jovanajanjatovic/Poboljsani-Haulandov-strujni-generator/README.md

U okviru predmeta Teorija električnih kola rađen je projekat o poboljšanom Houlandovom strujnom generatoru.
Ovo kolo predstavlja aktivni generator struje kod koga se odgovarajućim izborom otpornika postiže približno konstantna izlazna struja u zavisnosti od ulaznog napona

2025/2026<br>
Studentkinje: Mira Vukmirović i Jovana Janjatović<br>
Nastavnik: dr Nikola Basta, docent<br>
