jovanajanjatovic/Poboljsani-Haulandov-strujni-generator/zavisnost struje od otpora potrosaca.pdf

Rload [Ω] | Napon na Rload [V] | Struja kroz Rload [mA]
300 | 0.507 | 1.69
200 | 0.336 | 1.68
510 | 0.862 | 1.69
1500 | 2.462 | 1.64
5400 | 8.568 | 1.59
8000 | 12.16 | 1.52
