jovanajanjatovic/Poboljsani-Haulandov-strujni-generator/TEK_Projekat_Tim01_PoboljsaniHaulandovStrujniGenerator.pdf

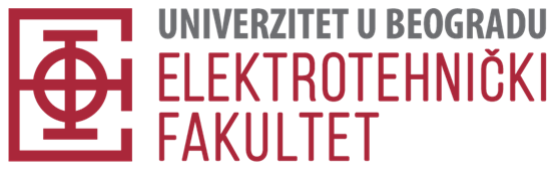
[picture p1: figure]

# Poboljšani Haulandov strujni generator

### Teorija električnih kola

2025/2026

## Tim 01

Studenti: Jovana Janjatović, Mira Vukmirović Nastavnik: dr Nikola Basta, docent

## Sadržaj

## 1. O poboljšanom Haulandovom strujnom generatoru

U okviru predmeta Teorija električnih kola izvodimo projekat o poboljšanom Haulandovom¹ strujnom generatoru. Ovo kolo predstavlja aktivni generator struje kod koga se odgovarajućim izborom otpornika postiže približno konstantna izlazna struja u zavisnosti od ulaznog napona.

Analizirano kolo se sastoji od operacionog pojačavača, mreže otpornika za ostvarivanje povratne sprege i opterećenja na izlazu. Kao referentna topologija korišćeno je kolo predstavljeno na Slici 1 preuzete iz [1], uz zamenu operacionog pojačavača OPA192 pojačavačem TL082.

Za simbolički proračun je rađen ručno, a za dodatni proveru i grafičke prikaze korišćen je programski jezik Python uz biblioteku SymPy, dok je simulacija kola izvršena u programu LTSpice.

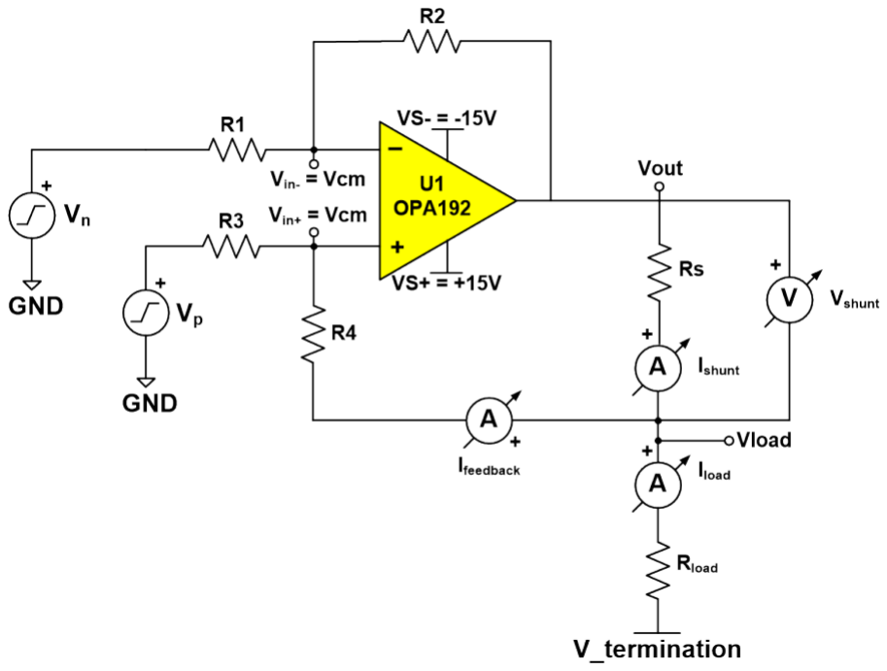
[picture p2: figure]

Slika 1

1 Bradford Howland (1927–2025) – američki inženjer elektrotehnike i istraživač.

## Kako radi ovo kolo?

Kao što je ranije rečeno, želimo da dobijemo strujni generator čija struja ne zavisi od opterećenja koje je priključeno na njega. To ćemo postići odgovarajućim izborom otpornika za koje mora da važi da je:

R2
R1

=

R4+Rs
R3

, povezanim u šemi sa operacionim pojačavačem sa negativnom povratnom spregom. Takođe, primetimo otpornik Rs. Operacioni pojačavač radi tako što poredi napon na ulazu i izlazu. Nama treba konstantna struja na izlazu, a ovaj otpornik služi da bi izlaz operacionog pojačavača video napon I znao kako da ga kompenzuje da bismo dobili željenu struju na opterećenju. Struja kroz otpornik Rs približno je jednaka struji kroz opterećenje, tako da Rs zapravo vidi truju na opterećenju I napon na izlazu operacionog pojačavača.

Vrednost konstantne struje na izlazu ne zavisi od opterećenja, ali zavisi od otpornika u kolu i ulaznog napona operacionog pojačavača.

U našem modelu Haulandovog strujnog generatora koristićemo sledeće komponente:

- Rs = 300Ω
- R1 = 100kΩ
- R2 = 10kΩ
- R3 = 100kΩ
- R4 = R2 − Rs = 9.7 kΩ
- Operacioni pojačavač TL082

Ulazne napone operacionog pojačavača kao i opterećenje možemo postavljati kasnije u zavnisnosti od potreba, mada ćemo se kroz dalji rad držati sledećih:

- Vp = 5V
- Vn = 0
- Rload = 1kΩ

## 2. Simbolički proračun

Operacioni pojačavač u simboličkom proračunu modelovan je kao idealan, pri čemu pretpostavljamo beskonačno pojačanje, zanemarljive ulazne struje i jednakost napona na invertujućem i neinvertujućem ulazu. Pod ovim pretpostavkama, za formiranje sistema jednačina, koristimo metod potencijala čvorova:

Va − Vo
R2

+

Va − Vn
R1

= 0

Vb − Vload
R4

+

Vb − Vp
R3

= 0

Vload − Vo
Rs +

Vload
Rload +

−Vb + Vload
R4

= 0

Rešavanjem ovog sistema jednačina, uz uslove polaznih pretpostavki, dobijamo sledeći izraz:

Iload =

Vp(R1(Rs + R4) + R2R4) − Vn(R2(R3 + R4)) R1(Rload(Rs + R4) + Rs(R3 + R4)) − R2R3Rload

tj. jednostavnije

Iload =

(R4 + Rs)(Vp − Vn)
R3Rs | =

(

R2
R1

) (Vp − Vn)

Rs

kada primenimo uslove za otpornike koje mora da zadovoljava kolo:

R2
R1

=

R4 + Rs
R3

Dobijena numerička vrednost struje kroz opterećenje:

Iload = 1.67mA

Link na Python kod u Google Collab-u može se naći ovde: link (https://colab.research.google.com/drive/13IQQVIiaV9_UaPV-3p1YHx0kn5hebOkF?usp=sharing)

## Grafici dobijeni proračunom u Python-u

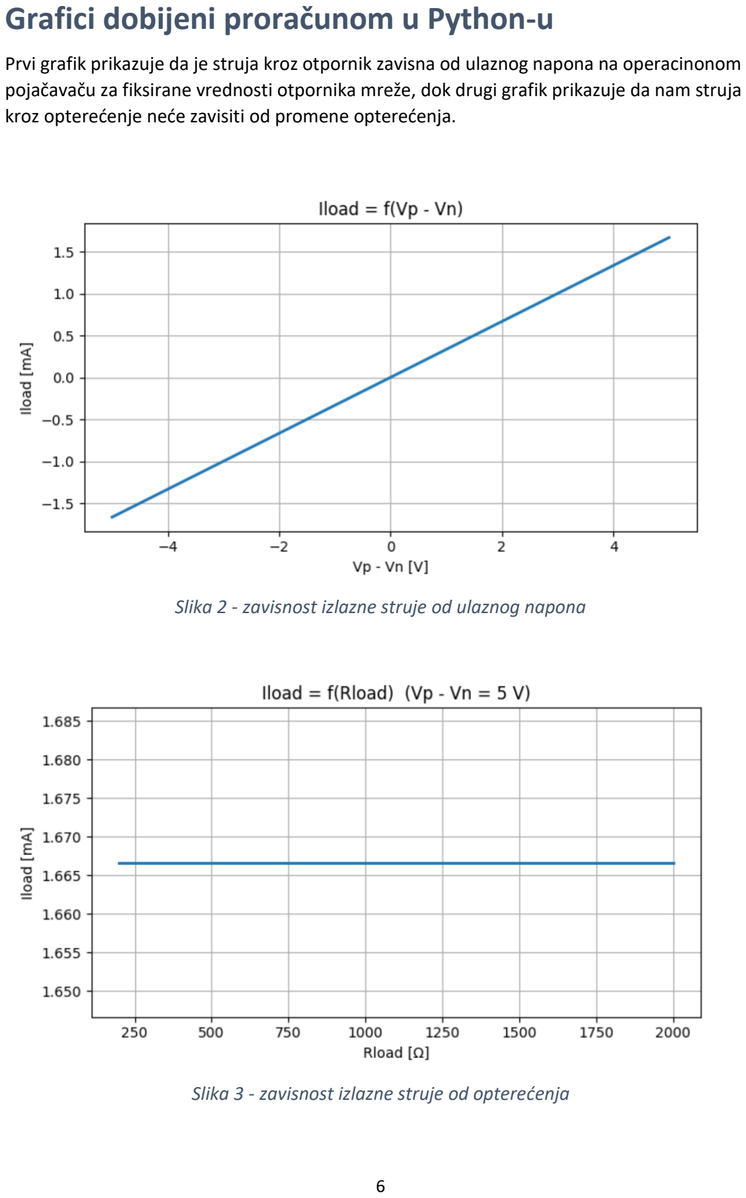
[picture p3: page 6]

Prvi grafik prikazuje da je struja kroz otpornik zavisna od ulaznog napona na operacinonom pojačavaču za fiksirane vrednosti otpornika mreže, dok drugi grafik prikazuje da nam struja kroz opterećenje neće zavisiti od promene opterećenja.

Slika 2 - zavisnost izlazne struje od ulaznog napona

Slika 3 - zavisnost izlazne struje od opterećenja

## 3. Simulacija kola

Šema i rezultati dobijeni u LTSpice-u mogu se videte na slikama ispod. Rezultati se poklapaju sa rezultatima dobijenim u simbolčkom proračunu.

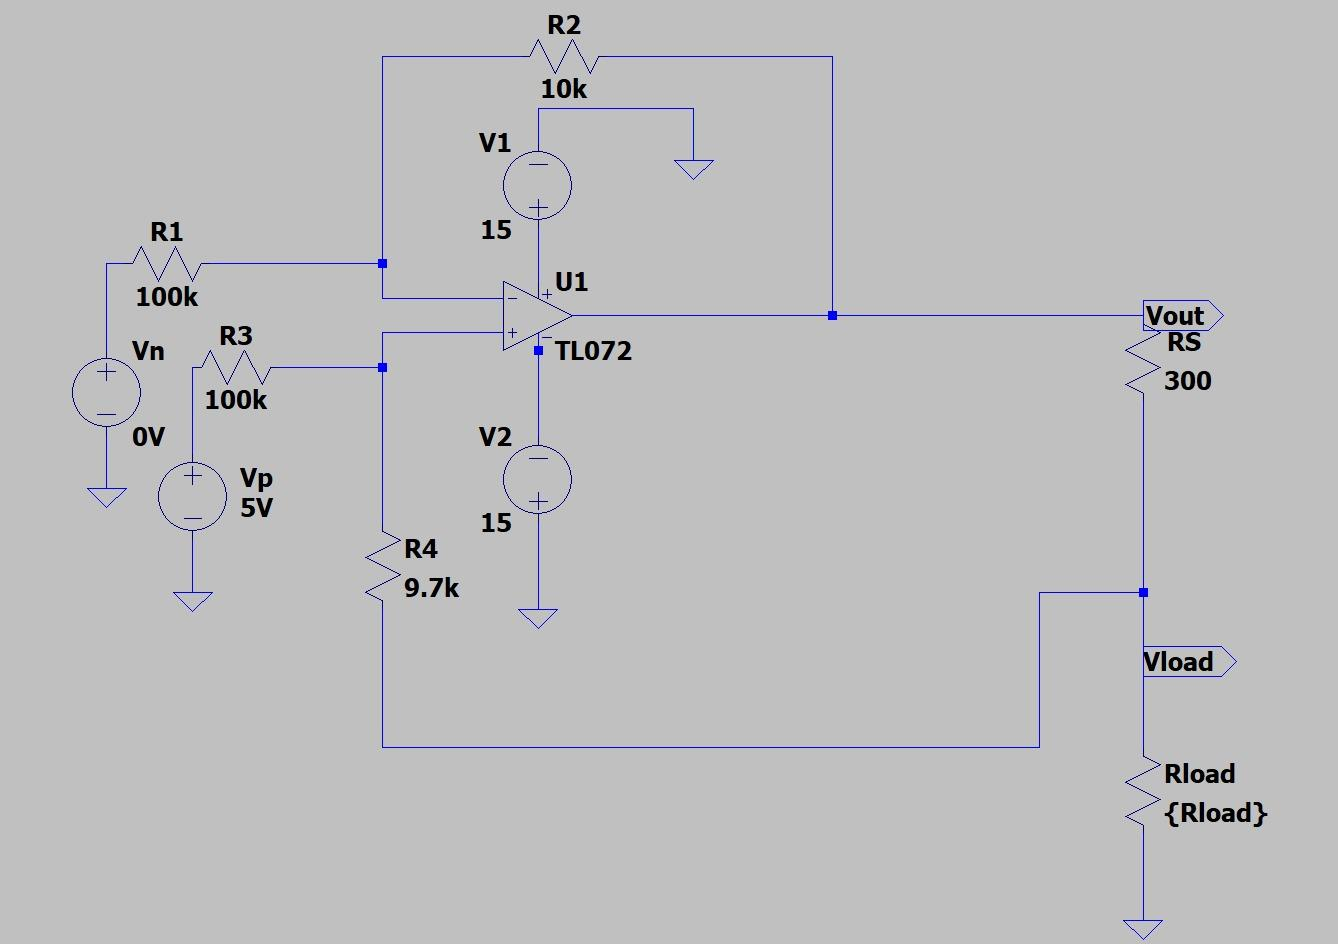
[picture p4: figure]

Slika 4 - šema kola u LTSpice-u

## Grafici dobijeni simulacijom u LTSpice-u

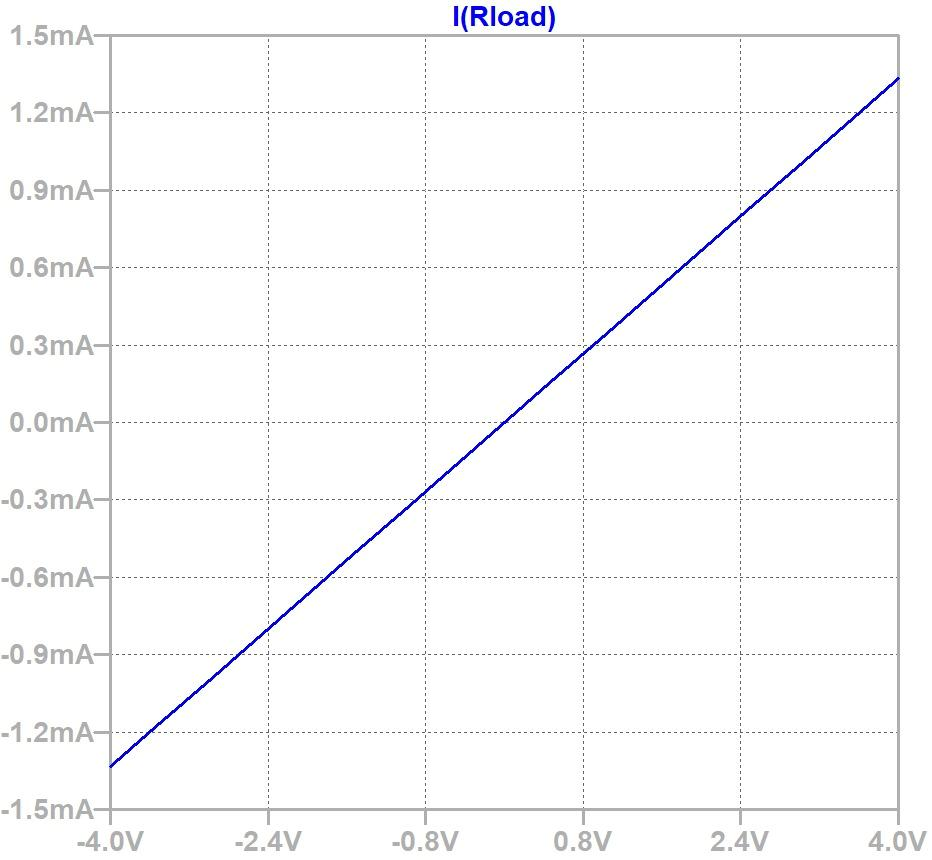
[picture p5: figure]

Slika 5 - zavisnost izlazne struje od ulaznog napona

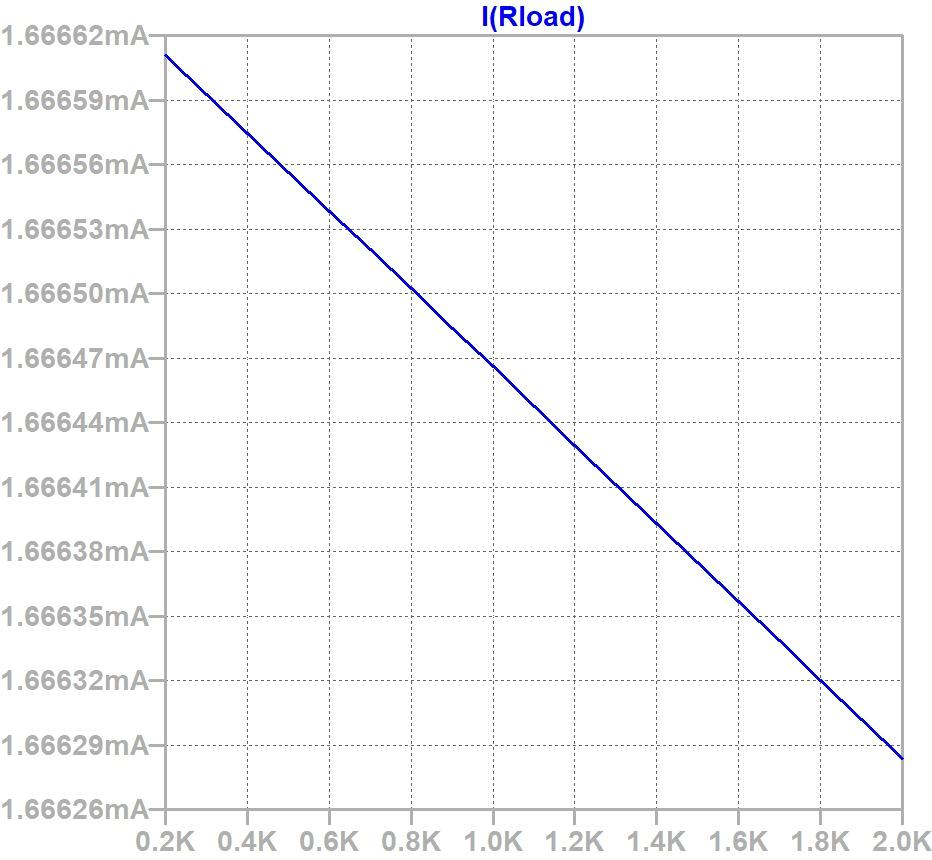
[picture p6: figure]

Slika 6 - zavisnost izlazne struje od opterećenja

## 4. Merenje

Napomena: U idealnom slučaju otpornik R4 treba da zadovolji odnos R4 = R2 − Rs
, čime se
postiže preciznije idealno ponašanje Improved Houlandovog generatora struje. Međutim, u praktičnoj realizaciji koristimo aproksimaciju R4 ≈ R2, zbog ograničene dostupnosti otpornika tačne vrednosti, što uvodi malu sistematsku grešku u izlaznoj struji i povećava osetljivost na opterećenje u odnosu na idealni slučaj.

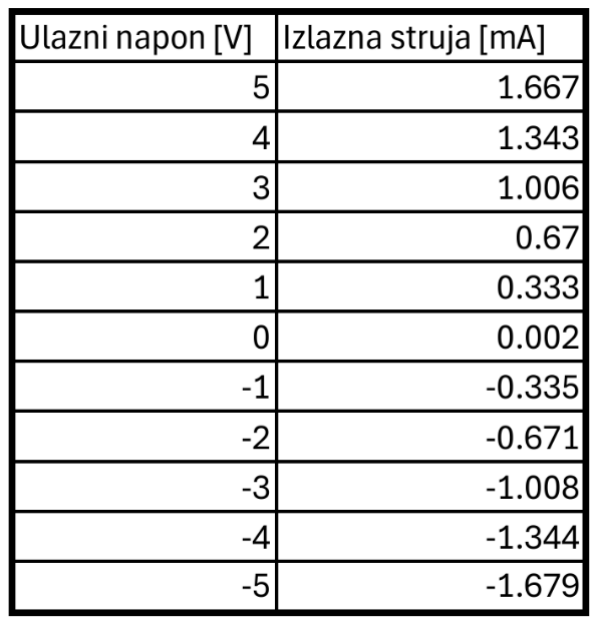
[picture p7: figure]

Tabela 1 – zavisnost izlazne struje od ulaznog napona

Kao što su proračun i simulacija pokazali, a zatim i vrednosti dobijene merenjem (upisane u tabelu 1), struja kroz potrošač zavisi od ulaznog napona na operacinonom pojačavaču za fiksirane vrednosti otpornika potrošača. U ovom slučaju, za fiksiranu vrednost otpornika Rload uzeta je vrednost od 1kΩ.

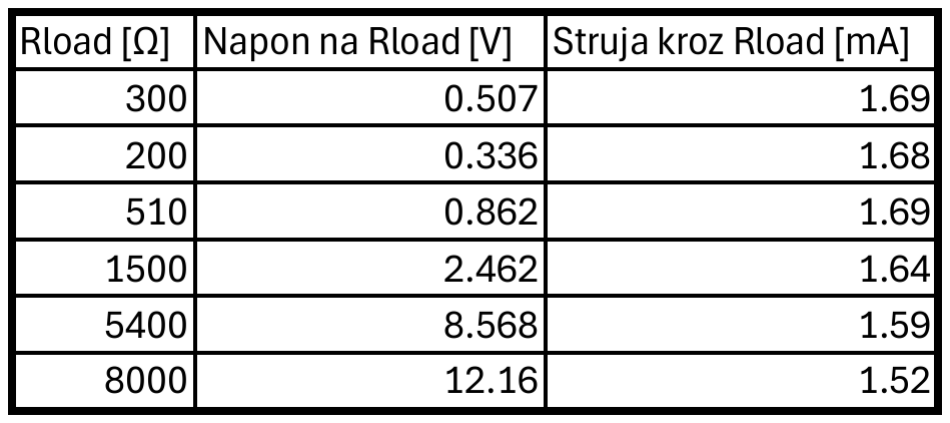
[picture p8: figure]

Tabela 2 – zavisnost stuje od napona potrošača

Ponovo, kao što je dobijeno u proračunu i u simulaciji, a sada potvrđeno egzaktnim merenjima (podaci se mogu naći u tabeli 2), vrednost struje kroz potrošač ne zavisi od otpora potrošača.

## Odziv Haulandovog strujnog generatora na ramp i sine pobudu

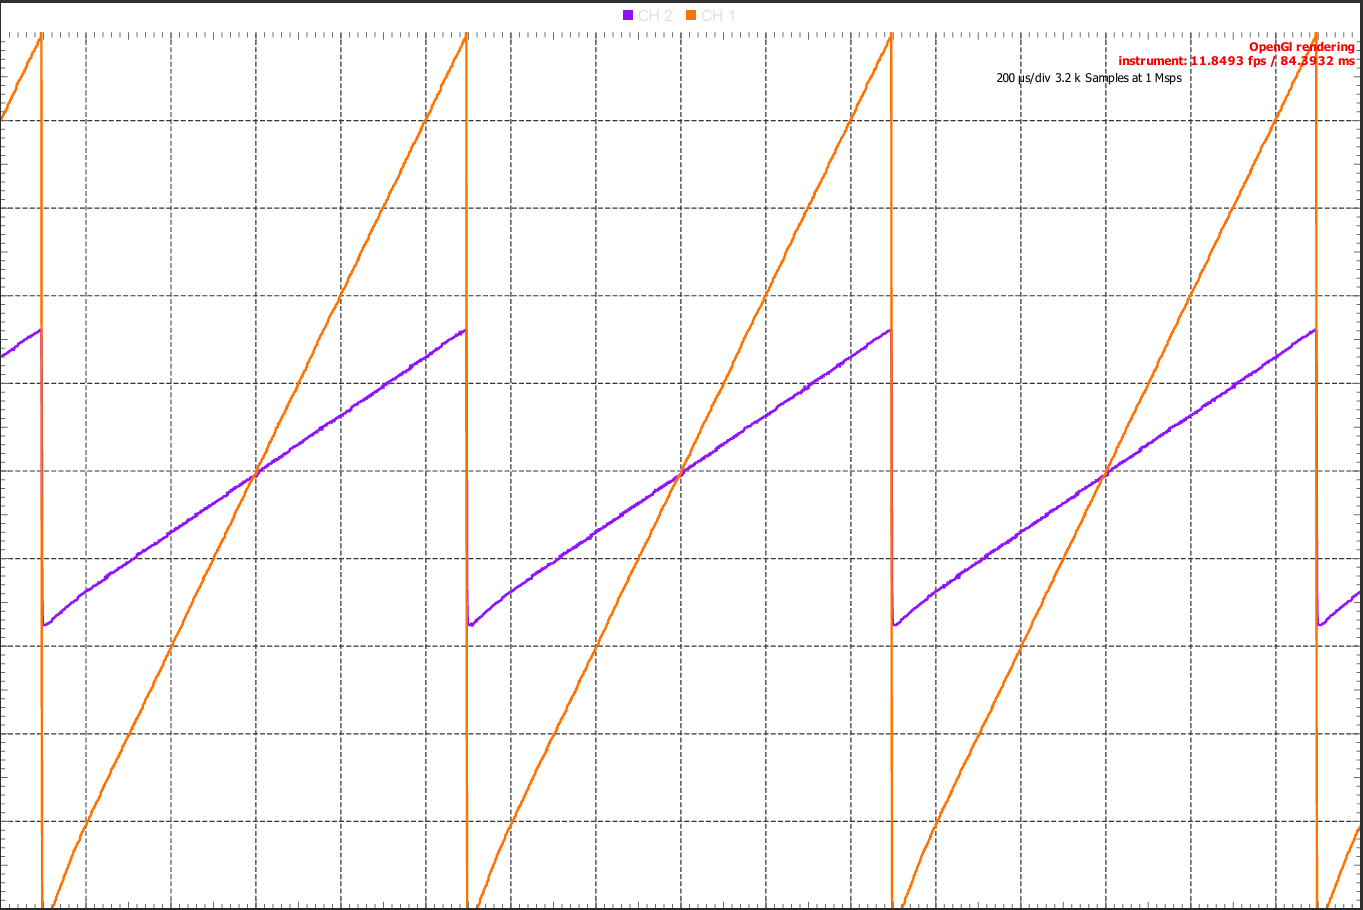
[picture p9: figure]

Slika 7 - Odziv poboljšanog Haulandovog strujnog generatora na ramp pobudu

Na slici je prikazan vremenski odziv poboljšanog Haulandovog strujnog generatora pri ramp pobudi. Ulazni signal ima oblik linearno rastućeg (ramp) napona, dok izlaz predstavlja odgovarajuću izlaznu struju koja zadržava isti vremenski oblik, ali je skalirana faktorom koji određuju otpornici u kolu. Linearni karakter odziva ukazuje na to da je struja direktno proporcionalna razlici ulaznih napona, dok operacioni pojačavač automatski prilagođava izlazni napon kako bi se održala željena vrednost struje nezavisno od opterećenja. Ovakav odziv potvrđuje pravilno podešavanje kola i ispunjenje uslova za rad kao strujni generator.

Takođe, isprobali smo i kakav bi bio odziv našeg kola na sine pobudu, tj. standardnu AC pobudu. On se može videti na slici ispod.

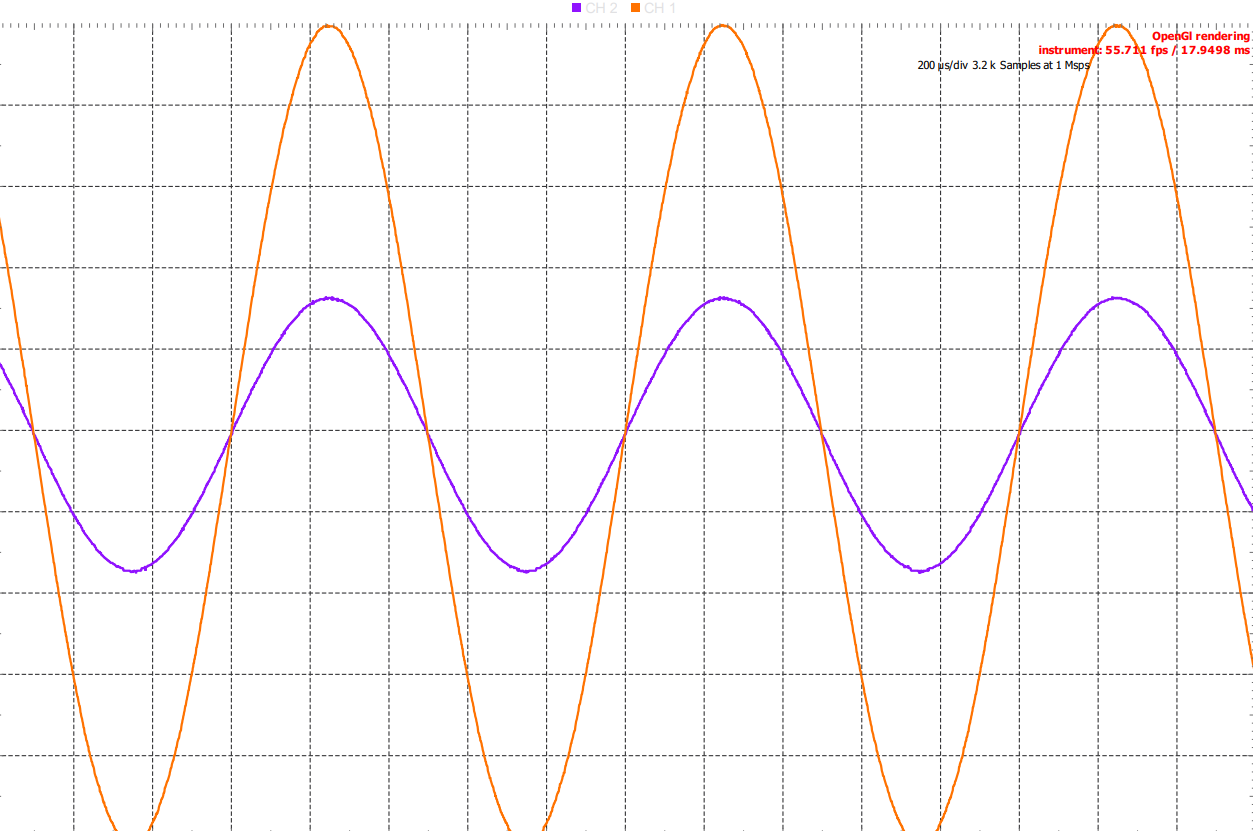
[picture p10: figure]

Slika 8 - Odziv poboljšanog Haulandovog strujnog generatora na sine pobudu

## Kako je izgledao naš rad u lab-u?

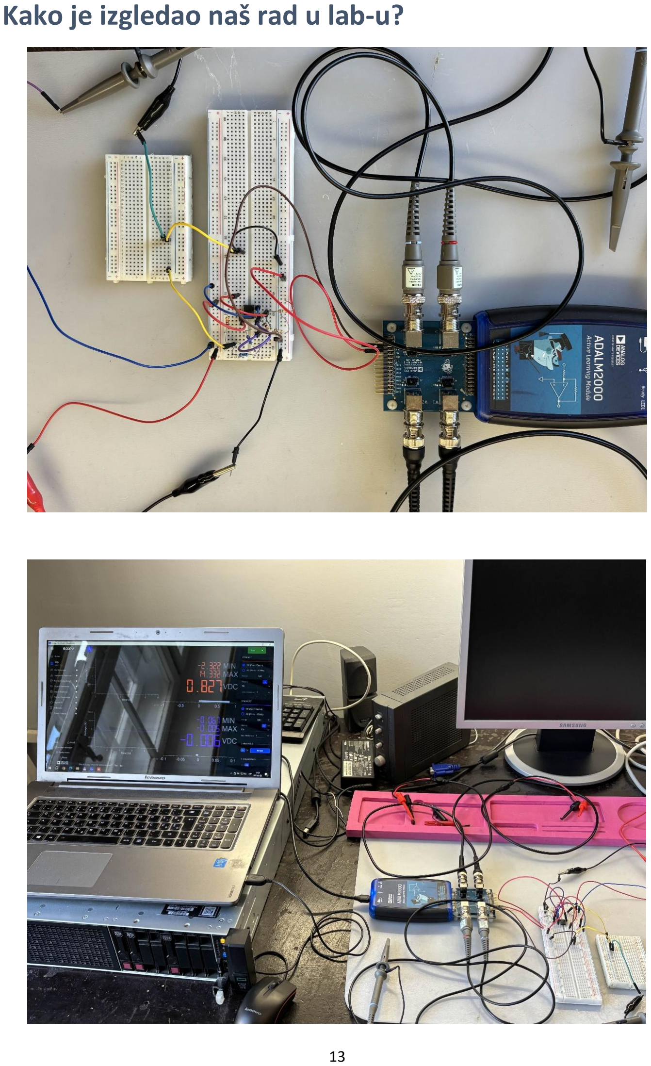
[picture p11: page 13]

## 5. Zaključak

Nakon merenja, možemo potvrditi da se rezultati dobijeni proračunom, simulacijom i merenjima u laboratoriji poklapaju.

Poboljšani Haulandov strujni generator ima primenu u sistemima gde je potrebna precizna kontrola struje, kao što su merni i akvizicioni sistemi, pobuda senzora, laboratorijska oprema i analogna signalna kola.

Takođe, klikom na ovaj link, (https://github.com/jovanajanjatovic/Poboljsani-Haulandov-strujni-generator.git) otići ćete ne repozitorijum na GitHub-u na kome se nalaze fajlovi simulacije i ostali pomoćni fajlovi.

## Literatura

[1] T. Instruments, "“Improved” Howland current pump circuit".
[2] E. Teorija električnih kola. [Online].
