jovanajanjatovic/Poboljsani-Haulandov-strujni-generator/Tim_01_OSC_Sawtooth.pdf

C
H

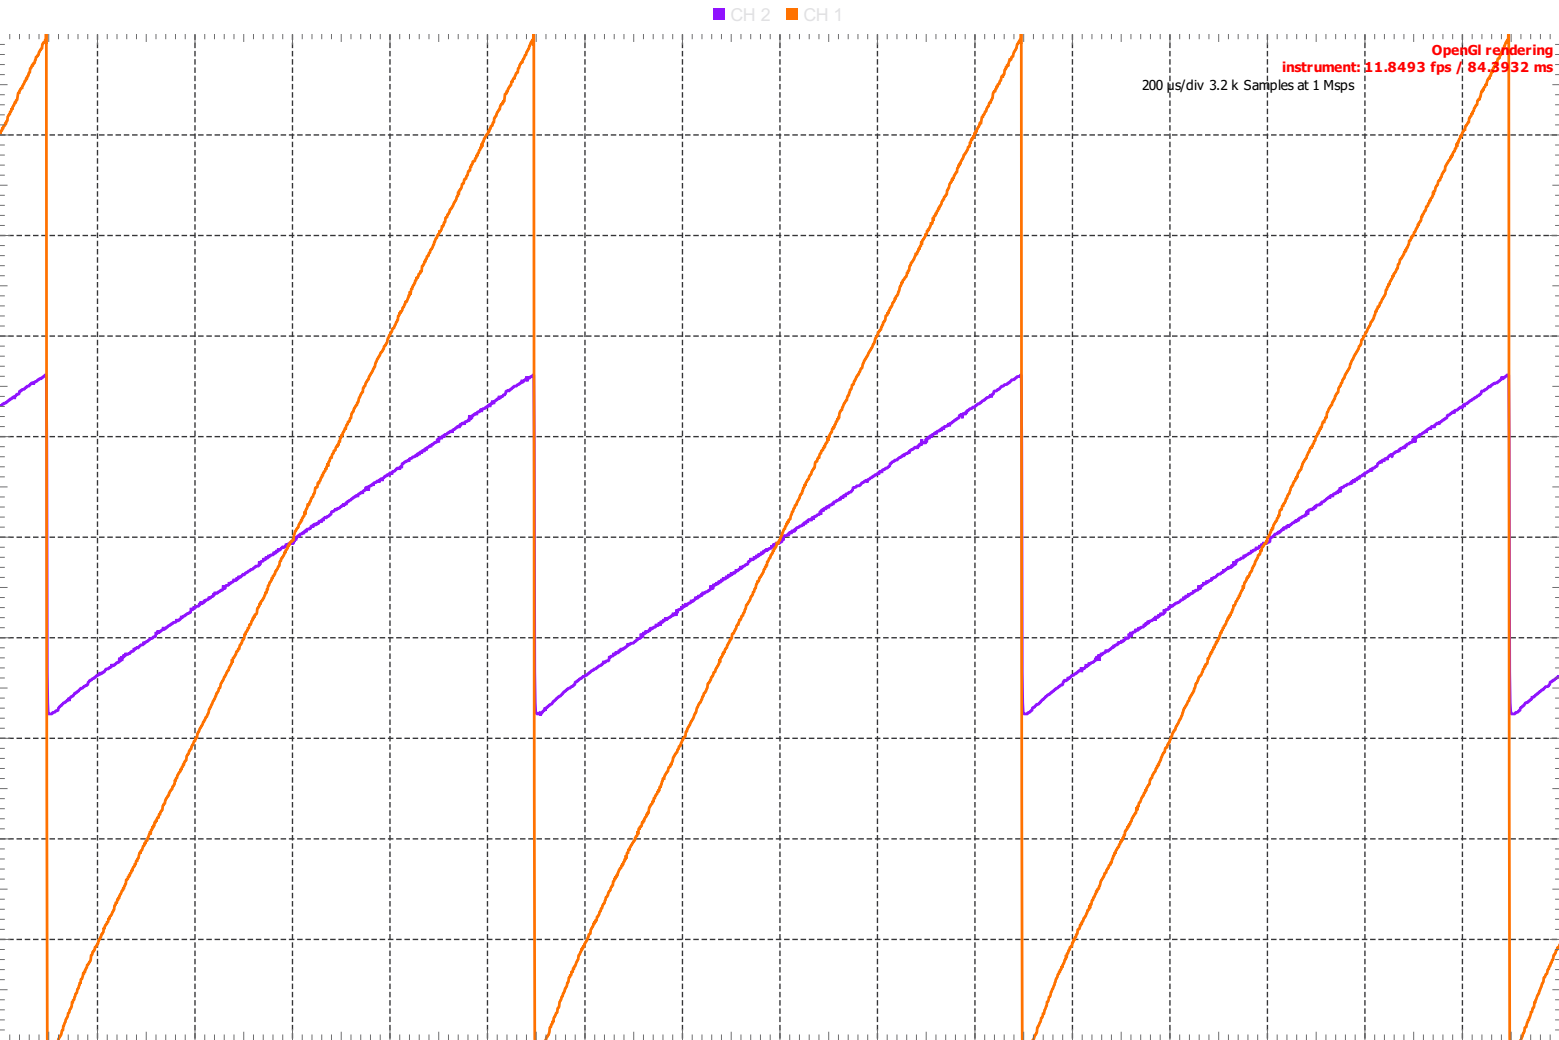
[picture p12: page 1]
div; ple s
