jovanajanjatovic/Poboljsani-Haulandov-strujni-generator/Tek_projekat.asc

R1: res; 100k; tol=1 pwr=0.1
R2: res; 10k
R3: res; 100k
R4: res; 10k
Rload: res; {RLOAD}
RS: res; 300
U1: opamp2; TL072
V1: voltage; 15
V2: voltage; 15
Vn: voltage; 0V
Vp: voltage; 5V
Named nets: 0, Vout, Vload
.op
;.dc VP -4 4 0.1
.include tl072.txt
.step param Rload 200 2000 100
